Dasiuss/Szusownik/supabase/functions/README.md

# supabase/functions/

Tu trafiają **Edge Functions** (każda w osobnym podfolderze z `index.ts`).

Planowane: `strava-upload/` — proxy do Strava (OAuth + upload FIT), na końcu.

Wdrażane automatycznie przez integrację Supabase ↔ GitHub przy push na `main`.
