Dasiuss/Szusownik/docs/assets/ikonki.png

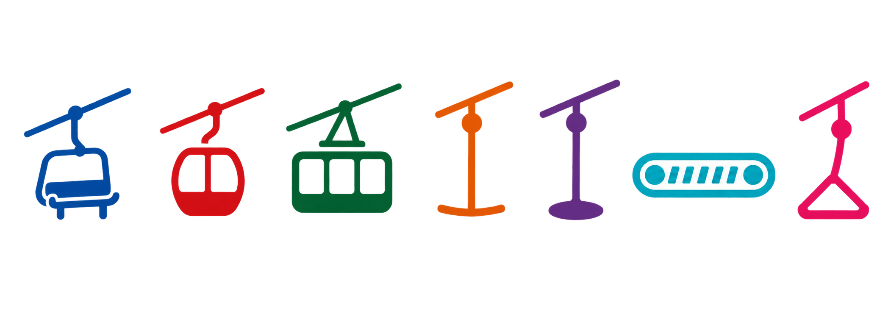
docs/assets/ikonki.png
