Dasiuss/Szusownik/test data/20260926_181420.csv

timestamp | lat | lon | speed | altitude_gps | heading | altitude_baro | gnss_fix_valid | gnss_fix_age_ms | gnss_satellites | gnss_satellites_age_ms | gnss_hdop | gnss_hdop_age_ms
2026-09-26T18:14:20.000Z | 51.050496 | 17.031226 | 1.6 | 130.8 | 189 | 40.3 | 1 | 25 | 12 | 2011 | 0.80 | 2011
2026-09-26T18:14:22.000Z | 51.050465 | 17.031216 | 9.6 | 131.0 | 191 | 40.5 | 1 | 13 | 12 | 1984 | 0.73 | 1984
2026-09-26T18:14:24.000Z | 51.050398 | 17.031197 | 16.0 | 131.1 | 190 | 39.8 | 1 | 13 | 12 | 1996 | 0.80 | 1996
2026-09-26T18:14:26.000Z | 51.050314 | 17.031166 | 17.9 | 130.9 | 193 | 39.7 | 1 | 13 | 12 | 1998 | 0.80 | 1998
2026-09-26T18:14:28.000Z | 51.050192 | 17.031119 | 26.8 | 130.5 | 191 | 40.2 | 1 | 71 | 12 | 2054 | 0.73 | 2054
2026-09-26T18:14:30.000Z | 51.050040 | 17.031069 | 34.9 | 130.5 | 192 | 40.9 | 1 | 12 | 12 | 3997 | 0.73 | 3997
2026-09-26T18:14:31.000Z | 51.049949 | 17.031033 | 38.6 | 130.4 | 192 | 40.5 | 1 | 13 | 12 | 998 | 0.73 | 998
2026-09-26T18:14:32.000Z | 51.049851 | 17.030997 | 40.5 | 130.2 | 192 | 40.0 | 1 | 13 | 12 | 996 | 0.73 | 996
2026-09-26T18:14:33.000Z | 51.049744 | 17.030958 | 43.7 | 130.4 | 192 | 40.8 | 1 | 12 | 12 | 997 | 0.72 | 997
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
