Dasiuss/Szusownik/firmware/Szusownik/Szusownik.ino

// Szusownik v1 — ESP32-S3-Zero, budowanie: arduino-cli (nie PlatformIO).
// FQBN: esp32:esp32:esp32s3:FlashSize=4M,PSRAM=enabled,USBMode=hwcdc,CDCOnBoot=cdc
// SSOT pinout: firmware/README.md
#include <Arduino.h>
#include <esp_system.h>
#include <TinyGPSPlus.h>
#include "src/config/pins.h"
#include "src/config/config.h"
#include "src/config/log.h"
#include "src/gnss/gnss.h"
#include "src/storage/storage.h"
#include "src/audio/audio.h"
#include "src/hud/hud.h"
#include "src/baro/baro.h"
#include "src/ble/ble.h"
#include "src/health/health.h"
#include "src/link/hud_link.h"
#include "src/core/run_tracker.h"
#include "src/core/hud_format.h"
#include "src/core/route.h"

static Gnss gnss;
static Storage storage;
static Beeper beeper;
static Hud hud;
static Baro baro;
static BleFiles ble;
static Health health;
static HudLink hudLink;
static core::RunTracker runTracker;

// Trasa nawigacyjna (RAM). Tożsamość = CRC32 bloba (routeVersion).
static RouteData activeRoute;
static uint32_t lastRouteVersion = 0;
static bool arrivalCleared = false;
// Ostatni znany odcinek trasy — zamrazany przy chwilowym braku fixa, żeby dolna
// linia OLED nie migotała i pokazywała ostatni znany stan.
static uint8_t routeSegmentNow = HUD_SEGMENT_NONE;
// Decyzja o bieżącym odcinku to pełny przebieg po punktach trasy (O(pointCount),
// double sqrt) — liczymy ją rzadko (SZ_ROUTE_UPDATE_MS), nie co iterację.
static unsigned long nextRouteMs = 0;
// Osobny, krótszy licznik na sprawdzenie dotarcia (odległość do końca, O(1)).
static unsigned long nextArrivalMs = 0;

// Statystyki dnia (reset przy restarcie = "max dnia od włączenia").
static float maxDayKmh = 0.0f;
static float totalKm = 0.0f;
static double prevLat = 0.0, prevLon = 0.0;
static bool havePrev = false;

static unsigned long nextHud = 0;
static unsigned long nextSync = 0;

// Miernik tempa zapisu i epok GNSS w oknie statusu.
static uint32_t totalSamples = 0;   // wiersze zapisane od startu
static uint32_t windowSamples = 0;  // wiersze w bieżącym oknie
static uint32_t windowEpochs = 0;   // epoki GNSS w bieżącym oknie
static unsigned long lastEpochMs = 0;
static unsigned long maxEpochGapMs = 0;
static unsigned long windowStart = 0;

// Zdarzenia (przejścia) — logowane raz, nie co próbkę.
static bool prevFix = false;
static bool prevTimeValid = false;

// Zdrowie pętli.
static unsigned long lastLoopMs = 0;
static unsigned long maxLoopMs = 0;
static uint32_t loopStallCount = 0;
static bool loopStallWarned = false;
static uint32_t loopIterations = 0;

static const char* resetReasonName(esp_reset_reason_t r) {
  switch (r) {
    case ESP_RST_POWERON: return "poweron";
    case ESP_RST_EXT: return "external";
    case ESP_RST_SW: return "software";
    case ESP_RST_PANIC: return "panic";
    case ESP_RST_INT_WDT: return "int_wdt";
    case ESP_RST_TASK_WDT: return "task_wdt";
    case ESP_RST_WDT: return "wdt";
    case ESP_RST_BROWNOUT: return "brownout";
    case ESP_RST_SDIO: return "sdio";
    default: return "other";
  }
}

void setup() {
  // Zegar CPU ustawiamy PRZED Serial i peryferiami: UART/I2C/LEDC mają wtedy
  // docelowy zegar od startu (patrz config.h).
  setCpuFrequencyMhz(SZ_CPU_FREQ_MHZ);
  Serial.begin(115200);
  unsigned long t0 = millis();
  while (!Serial && millis() - t0 < 1500) {
  }
  SZ_LOGIF("Szusownik %s proto=%s", SZ_FW_VERSION, SZ_WIRE_PROTO);
  SZ_LOGIF("BOOT reset=%s cpu=%luMHz heap=%lu psram=%lu", resetReasonName(esp_reset_reason()),
           (unsigned long)getCpuFrequencyMhz(), (unsigned long)ESP.getFreeHeap(),
           (unsigned long)ESP.getFreePsram());

  gnss.begin(9600);  // NEO-M8N default; reszta (rate/baud/zapis) w gnss.maintain()
  if (!storage.begin()) {
    SZ_LOGE("SD blad init");
  } else {
    SZ_LOGI("SD ok");  // plik powstanie dopiero przy poprawnej dacie/czasie GNSS
  }
  if (!hud.begin()) {
    SZ_LOGE("OLED blad init");
  }
  if (!baro.begin()) {
    SZ_LOGE("BARO blad init");
  } else if (baro.read()) {
    SZ_LOGIF("BARO %s @0x%02X P=%.1f Pa T=%.1f C alt=%.1f m", baro.typeName(), baro.address(),
             baro.pressurePa(), baro.tempC(), baro.altitudeM());
  } else {
    SZ_LOGIF("BARO %s @0x%02X (odczyt blad)", baro.typeName(), baro.address());
  }
  beeper.begin();
  beeper.playBoot();  // sygnał 120 (1 długi + 2 krótkie) przy głośności 60
  ble.setBeeper(&beeper);
  ble.begin(&storage);
  health.begin(&storage, &beeper, &hud, &baro);
  hudLink.begin();  // ESP-NOW do HudRekaw (kanał 1)
  lastRouteVersion = ble.routeVersion();
  routeDecode(ble.routeRaw(), ble.routeRawLen(), &activeRoute);
  hudLink.setRoute(ble.routeRaw(), ble.routeRawLen(), lastRouteVersion);

  windowStart = millis();
  nextSync = windowStart + SZ_SD_COMMIT_MS;
  SZ_LOGI("BOOT ok");
}

void loop() {
  unsigned long now = millis();

  // --- zdrowie pętli (wykrywa blokady I2C/SD/BLE/Serial) ---
  if (lastLoopMs) {
    unsigned long dt = now - lastLoopMs;
    if (dt > maxLoopMs) maxLoopMs = dt;
    if (dt >= SZ_LOOP_STALL_WARN_MS) {
      loopStallCount++;
      if (!loopStallWarned) {
        SZ_LOGWF("SYS loop stall %lums", dt);
        loopStallWarned = true;
      }
    }
  }
  lastLoopMs = now;
  loopIterations++;

  gnss.poll();
  gnss.maintain(now);  // autokonfiguracja UBX (co 5 s aż do skutku) + logi
  bool fix = gnss.hasFix();
  float kmh = fix ? gnss.speedKmh() : 0.0f;

  // Zdarzenia GNSS (raz na przejście, nie per próbka).
  if (fix != prevFix) {
    if (fix) {
      SZ_LOGIF("GNSS fix acquired sats=%lu hdop=%.2f", (unsigned long)gnss.sats(), gnss.hdop());
    } else {
      SZ_LOGIF("GNSS fix lost (sats=%lu age=%lums)", (unsigned long)gnss.sats(),
               gnss.locationAgeMs());
    }
    prevFix = fix;
  }
  if (!prevTimeValid && gnss.timeValid()) {
    prevTimeValid = true;
    SZ_LOGI("GNSS UTC valid (mozna tworzyc plik)");
  }

  // Rolka na postoju: domyka plik, gdy stoimy (chroni dane przed odcięciem
  // zasilania). Wołane co iterację (na millis), nie tylko na nowej próbce.
  storage.updateFileRotation(kmh, fix);
  // .meta po potwierdzonym ruchu: bez niego plik jest uznawany za postojowy
  // i nie trafia do listy pobierania (PWA go nie widzi).
  storage.ensureMeta();

  // Zapis na nadejście nowej próbki GNSS (commit RMC), nie na zegarze pętli.
  // Gwarantuje 1 wiersz = 1 pomiar i brak duplikatów przy dudnieniu zegarów.
  if (gnss.consumeNewSample()) {
    windowEpochs++;
    if (lastEpochMs) {
      unsigned long gap = now - lastEpochMs;
      if (gap > maxEpochGapMs) maxEpochGapMs = gap;
    }
    lastEpochMs = now;

#if SZ_LOG_LEVEL >= 3
    // Jedyna per-próbka linia (DEBUG). Wycinana kompilacyjnie w produkcji —
    // dane per próbka są trwale w CSV, a status okresowy wystarcza do oceny.
    SZ_LOGDF("GNSS smpl ok=%d spd=%.1f sats=%lu hdop=%.2f age=%lums altBaro=%.1f "
             "lat=%.6f lon=%.6f alt=%.1f hdg=%.0f",
             fix ? 1 : 0, kmh, (unsigned long)gnss.sats(), gnss.hdop(), gnss.locationAgeMs(),
             baro.valid() ? baro.altitudeM() : 0.0f, gnss.lat(), gnss.lon(), gnss.altM(),
             gnss.headingDeg());
#endif

    if (fix) {
      // Statystyki dnia (max i dystans) liczymy raz na nową próbkę — nie co
      // iterację pętli: haversine to 8 transcendentalnych `double`, a wartość
      // zmienia się dopiero na nowej epoce GNSS. Max zjazdu liczy
      // core::RunTracker (port ZigZag z PWA) niżej.
      if (kmh > maxDayKmh) maxDayKmh = kmh;
      if (kmh >= SZ_SPD_STATIC_BELOW_KMH) {
        double la = gnss.lat(), lo = gnss.lon();
        if (havePrev) {
          double d = TinyGPSPlus::distanceBetween(prevLat, prevLon, la, lo);
          if (d >= 0.0 && d < 200.0) totalKm += (float)(d / 1000.0);
        }
        prevLat = la;
        prevLon = lo;
        havePrev = true;
      }

      // Baro czytamy raz na epokę (i tak potrzebny do CSV i do fuzji HUD).
      if (baro.present()) baro.read();
      const bool baroOk = baro.present() && baro.valid();
      const float baroAlt = baroOk ? baro.altitudeM() : 0.0f;

      // HUD: tracker zjazdu (fuzja baro+GPS + ZigZag) na każdej epoce z fixem.
      runTracker.update(kmh, gnss.altM(), baroAlt, true, now);

      // Plik powstaje dopiero, gdy GNSS poda poprawną datę/czas (nazwa = UTC).
      // Bez tego nie nazwiemy pliku, więc próbkę pomijamy i nie dotykamy SD.
      if (storage.isReady() && !storage.isOpen()) {
        String stamp = gnss.utcStamp();
        if (stamp.length()) storage.openLog(stamp);
      }
      if (storage.isReady() && storage.isOpen()) {
        const GnssSampleQuality quality = gnss.sampleQuality();
        storage.writeSample(gnss.csvStamp(), gnss.lat(), gnss.lon(), kmh, gnss.altM(),
                            gnss.headingDeg(), baroAlt, quality);
        totalSamples++;
        windowSamples++;
      }
    }
  }

  if (now >= nextSync) {
    nextSync = now + SZ_SD_COMMIT_MS;
    // fsync (`File::flush` -> f_sync) dzieli SPI z odczytem transferu i na tej
    // karcie potrafi być długi. W trakcie transferu pomijamy go (dane w buforze
    // stdio domkną się po transferze albo na rolce), żeby nie zjadał zegara ACK.
    if (!ble.busy()) storage.sync();
  }
  if (now >= nextHud) {
    nextHud = now + 500;
    int utcHour = -1, utcMinute = 0, utcSecond = 0;
    char routeLine[SZ_HUD_ROUTE_CHARS + 1];
    gnss.utcTime(utcHour, utcMinute, utcSecond);
    HudData data;
    data.speedKmh = kmh;
    data.maxRunKmh = runTracker.displayMaxKmh();
    data.maxDayKmh = maxDayKmh;
    data.totalKm = totalKm;
    data.altitudeM = runTracker.altitudeM();
    data.utcHour = utcHour;
    data.utcMinute = utcMinute;
    data.hasFix = fix;
    // Dolna linia: kolejne odcinki od bieżącego (albo od początku, gdy odcinek
    // jeszcze nieznany). Bez trasy linia zostaje pusta (pełny ekran statystyk).
    data.routeLine = nullptr;
    if (activeRoute.valid && activeRoute.segmentCount > 0) {
      const uint8_t start =
          routeSegmentNow != HUD_SEGMENT_NONE ? routeSegmentNow : 0;
      routeFormatLine(activeRoute, start, routeLine, sizeof(routeLine));
      if (routeLine[0] != '\0') data.routeLine = routeLine;
    }
    hud.draw(data);
  }

  // Jedna linia statusu (DEBUG) zamiast dawnych "GPS:" + "LOG:".
  if (now - windowStart >= SZ_STATUS_MS) {
    unsigned long win = now - windowStart;
    float sampleHz = win ? windowSamples * 1000.0f / (float)win : 0.0f;
    float epochHz = win ? windowEpochs * 1000.0f / (float)win : 0.0f;
    float loopAvg = loopIterations ? (float)win / (float)loopIterations : 0.0f;
    float airC = (baro.present() && baro.valid()) ? baro.tempC() : 0.0f;
    SZ_LOGDF("SYS fix=%d sats=%lu hdop=%.2f age=%lums band=%d rate=%lums cfg=%d chars=%lu "
             "ubxfail=%lu | sd=%s file=%s wr=%lu err=%lu syncMax=%lums | "
             "smp=%.2fHz ep=%.2fHz gapMax=%lums | loop=%.1f/%lums stall=%lu | "
             "heap=%lu min=%lu psram=%lu | die=%.1f air=%.1f | ble=%s mtu=%u nf=%lu",
             gnss.hasFix() ? 1 : 0, (unsigned long)gnss.sats(), gnss.hdop(), gnss.locationAgeMs(),
             gnss.band(), gnss.logIntervalMs(), gnss.isConfigured() ? 1 : 0,
             (unsigned long)gnss.charsProcessed(), (unsigned long)gnss.ubxFails(),
             storage.isOpen() ? "open" : "idle", storage.currentName().c_str(),
             (unsigned long)totalSamples, (unsigned long)storage.writeErrors(),
             storage.syncMaxMs(), sampleHz, epochHz, maxEpochGapMs, loopAvg, maxLoopMs,
             (unsigned long)loopStallCount, (unsigned long)ESP.getFreeHeap(),
             (unsigned long)ESP.getMinFreeHeap(), (unsigned long)ESP.getFreePsram(),
             temperatureRead(), airC, ble.busy() ? "xfer" : "idle", (unsigned)ble.mtu(),
             (unsigned long)ble.notifyFails());

    windowStart = now;
    windowSamples = 0;
    windowEpochs = 0;
    maxEpochGapMs = 0;
    maxLoopMs = 0;
    loopStallCount = 0;
    loopStallWarned = false;
    loopIterations = 0;
    storage.resetSyncStats();
  }

  beeper.tick(kmh, now);
  health.tick(now);  // termika: alarm >95C, deep sleep >100C
  ble.poll();  // callback BLE tylko ustawia flagi (poll czyta CTRL); bez blokowania SD
  // Reklamowanie zależne od prędkości: na postoju szybkie (PWA łączy się od razu),
  // w ruchu wolne (mniej grzania). Tanie — przełącza tylko przy zmianie stanu.
  ble.updateAdvForSpeed(kmh);

  // Trasa nawigacyjna: wykryj zmianę wersji (PWA albo lokalny CLEAR po dotarciu),
  // przelicz bieżący odcinek i obsłuż dotarcie do celu.
  const uint32_t routeVersion = ble.routeVersion();
  if (routeVersion != lastRouteVersion) {
    lastRouteVersion = routeVersion;
    routeDecode(ble.routeRaw(), ble.routeRawLen(), &activeRoute);
    hudLink.setRoute(ble.routeRaw(), ble.routeRawLen(), routeVersion);
    arrivalCleared = false;
    routeSegmentNow = HUD_SEGMENT_NONE;  // nowa trasa: brak znanego odcinka
    nextRouteMs = 0;                     // nowa trasa: przelicz od razu
    nextArrivalMs = 0;
  }

  // Dotarcie: odległość do końca trasy jest O(1) — sprawdzamy ją co najwyżej raz
  // na SZ_ROUTE_ARRIVAL_MS. Rzadsze próbkowanie mogłoby przy dużej prędkości
  // przeskoczyć cały promień ROUTE_ARRIVAL_M (~60 m okna) i zgubić dotarcie.
  if (activeRoute.valid && fix && !arrivalCleared && now >= nextArrivalMs) {
    nextArrivalMs = now + SZ_ROUTE_ARRIVAL_MS;
    if (routeDistanceToEndM(activeRoute, gnss.lat(), gnss.lon()) <= ROUTE_ARRIVAL_M) {
      arrivalCleared = true;
      ble.clearRoute();  // trasa znika też z HudRekaw (przez ESP-NOW)
    }
  }

  // Bieżący odcinek: pełny przebieg po punktach trasy liczymy co najwyżej raz na
  // SZ_ROUTE_UPDATE_MS (odcinek zmienia się wolno, a liczenie w każdej iteracji
  // dogrzewało SoC). Między przeliczeniami pakiet niesie ostatni znany odcinek.
  uint8_t segmentIndex = HUD_SEGMENT_NONE;
  if (activeRoute.valid && fix) {
    if (now >= nextRouteMs) {
      nextRouteMs = now + SZ_ROUTE_UPDATE_MS;
      routeSegmentNow = routeSegmentIndex(activeRoute, gnss.lat(), gnss.lon());
    }
    segmentIndex = routeSegmentNow;
  }
  if (!activeRoute.valid) routeSegmentNow = HUD_SEGMENT_NONE;

  // ESP-NOW do HudRekaw. Pauza w trakcie transferu BLE chroni sprawdzone pasmo.
  HudInput hudIn;
  hudIn.fix = fix;
  hudIn.speedKmh = kmh;
  hudIn.maxDayKmh = static_cast<uint16_t>(maxDayKmh + 0.5f);
  hudIn.heading = static_cast<int16_t>(lroundf(gnss.headingDeg()));
  hudIn.totalKm = totalKm;
  hudIn.latE7 = static_cast<int32_t>(lround(gnss.lat() * 1e7));
  hudIn.lonE7 = static_cast<int32_t>(lround(gnss.lon() * 1e7));
  hudIn.segmentIndex = segmentIndex;

  // Parowanie HUD (zlecone z PWA przez BLE): zlecenie → HudLink, wynik → PWA.
  // Sparowany MAC trafia też do INFO (ble.setHudPeer) dla widoku w PWA. INFO
  // aktualizujemy PRZED STATUS-em wyniku — PWA czyta INFO zaraz po STATUS-ie,
  // więc przy odwrotnej kolejności widziałaby stary peerMac. setHudPeer odświeża
  // INFO tylko przy rzeczywistej zmianie (jedno skanowanie katalogu SD).
  if (ble.takePairRequest()) hudLink.requestPairing();
  ble.setHudPeer(hudLink.peerMac());
  HudPairResult pairResult;
  if (hudLink.takePairResult(pairResult)) {
    char msg[48];
    if (pairResult == HudPairResult::Ok) {
      const uint8_t* m = hudLink.peerMac();
      snprintf(msg, sizeof(msg), SZ_ST_PAIRED " %02X:%02X:%02X:%02X:%02X:%02X", m[0], m[1], m[2],
               m[3], m[4], m[5]);
      ble.reportHudPair(msg);
    } else if (pairResult == HudPairResult::None) {
      ble.reportHudPair(SZ_ERR_PAIR_NONE);
    } else if (pairResult == HudPairResult::TooMany) {
      ble.reportHudPair(SZ_ERR_PAIR_MULTI);
    } else {
      ble.reportHudPair(SZ_ST_ERR "pair");
    }
  }

  // Świeży czas dla linku HUD: od początku loop() do tego miejsca mogą wystąpić
  // blokujące operacje (skan katalogu SD w refreshInfo po wyczyszczeniu MAC-a
  // przy parowaniu, zapis SD), a okna nadawania i okno zbierania odpowiedzi na
  // 'P' (prośba o parowanie) liczą się od rzeczywistego „teraz".
  hudLink.tick(millis(), hudIn, ble.busy());

  // Oddaj CPU na chwilę, ale NIE w trakcie transferu BLE: profil BLE jest
  // zamrożony (spacing NOTIFY 4 ms), więc pompa musi kręcić się bez sztucznego
  // opóźnienia. Poza transferem delay wpuszcza idle/DFS i ogranicza grzanie
  // SoC; 3 ms nie rusza żadnego interwału (najszybszy to GNSS 10 Hz = 100 ms).
  if (!ble.busy()) delay(SZ_LOOP_IDLE_MS);
}
