Dasiuss/Szusownik/firmware/Szusownik/src/config/config.h

#pragma once
#include <Arduino.h>
#include "protocol.h"

// Szusownik v1 — stałe konfiguracyjne. SSOT decyzji: docs/koncepcja.md,
// docs/wymagania-ESP.md, docs/ble-transfer.md, docs/jakosc-danych.md.

#define SZ_FW_VERSION "1.9.0-hud-espnow"
// SZ_WIRE_PROTO, SZ_CSV_HEADER i SZ_CSV_META_SUFFIX są w protocol.h.

// Adaptacyjne próbkowanie (docs/koncepcja.md): <20:0.5Hz, 20-50:1Hz,
// 50-70:3Hz, 70-80:6Hz, >=80:10Hz. Histereza +/-3 km/h.
static const float SZ_HYST_KMH = 3.0f;

// Buzzer: mapowanie prędkość -> wzór jest w audio.cpp; zakresy i wartości
// domyślne (częstotliwości, czasy tonów/przerw, próg pikania, głośność) są
// w protocol.h — PWA i firmware czytają te same liczby.


// Rotacja pliku na postoju (wymagania-ESP.md §7). Gdy prędkość spadnie poniżej
// SZ_ROLL_STOP_BELOW_KMH i utrzyma się przez SZ_ROLL_HOLD_MS, bieżący plik jest
// domykany — w chwili odcięcia zasilania otwarty jest już tylko plik z próbkami
// z postoju (bezwartościowy). Ponowne uzbrojenie rolki dopiero po prędkości
// > SZ_ROLL_REARM_ABOVE_KMH przez SZ_ROLL_HOLD_MS, więc jeden postój = jedna
// rolka (bez mnożenia plików); ruch < SZ_ROLL_REARM_ABOVE_KMH nie jest chroniony.
#define SZ_ROLL_STOP_BELOW_KMH 0.3f
#define SZ_ROLL_REARM_ABOVE_KMH 5.0f
#define SZ_ROLL_HOLD_MS 3000UL

// Monitoring zdrowia urzadzenia (modul Health). MVP: termika SoC.
// ESP32-S3 NIE ma sprzetowego zabezpieczenia termicznego, wiec ochrona jest
// programowa: sprawdzenie co SZ_HEALTH_CHECK_MS; po SZ_HEALTH_WARN_CONFIRM
// kolejnych odczytach >= WARN kazdy kolejny odczyt >= WARN daje alarm buzzerem
// (SZ_HEALTH_ALARM_MS). Przy >= CRIT: zamkniecie SD, ekran, alarm i deep sleep.
// Uwaga: temperatureRead() jest slabo skalibrowany bezwzglednie — progi
// ustawione z zapasem (CRIT 100 < junction max 125). Histereza chroni przed
// zatrzasnieciem alarmu po ostygnięciu.
#define SZ_HEALTH_CHECK_MS 30000UL
#define SZ_HEALTH_TEMP_WARN_C 95.0f
#define SZ_HEALTH_TEMP_CRIT_C 100.0f
#define SZ_HEALTH_WARN_CONFIRM 3
#define SZ_HEALTH_ALARM_MS 3000
#define SZ_HEALTH_HYST_C 2.0f

// HUD: próg ruchu dla liczenia dystansu (km). SPD na ekranie pokazuje zawsze
// bieżącą prędkość; hero "max zjazdu" liczy core::RunTracker (port ZigZag z PWA).
#define SZ_SPD_STATIC_BELOW_KMH 5.0f

// HUD: strefa czasowa (minuty) dla wyświetlanego czasu lokalnego (UTC+offset).
#define SZ_HUD_TZ_OFFSET_MIN 60

// HUD: pojemność dolnej linii trasy. W trybie trasy napis jest rozmiaru 2
// (12 px/znak) od x=1 — mieści się 10 znaków przy szerokości 128 px. Dłuższy
// napis jest urywany w środku nazwy, bez wiszącego "->".
#define SZ_HUD_ROUTE_CHARS 10

// Trasa nawigacyjna: maksymalna częstość przeliczania bieżącego odcinka.
// Pełny przebieg po punktach trasy (O(pointCount), double sqrt) jest kosztowny,
// a odcinek zmienia się wolno — liczymy go najwyżej raz na ten interwał.
// Odległość do końca trasy (wykrycie dotarcia) jest O(1) i sprawdzana osobno,
// nie rzadziej niż SZ_ROUTE_ARRIVAL_MS — rzadsze próbkowanie przy dużej
// prędkości mogłoby przeskoczyć promień ROUTE_ARRIVAL_M i zgubić dotarcie.
#define SZ_ROUTE_UPDATE_MS 3000UL
#define SZ_ROUTE_ARRIVAL_MS 1000UL

// Przekazywanie trasy do HudRekaw po ESP-NOW: minimalny odstęp między oknami
// wysyłki trasy. Okno = burst chunków `R` (każdy następny po ACK poprzedniego)
// zakończony oczekiwaniem na jawne potwierdzenie `K` z CRC, do
// HUD_ROUTE_MAX_CYCLES prób (patrz protocol/hud-espnow-v1.json). Po nieudanym
// oknie czekamy — Hud zgłosi inną wersję trasy, ale bez tego progu burst
// restartowałby się natychmiast i radio nadawało non-stop (dogrzewanie).
// Szczegóły: docs/hud-rekaw.md §3.
#define SZ_HUD_ROUTE_RESEND_MS 9000UL

// Detekcja zjazdu (port ZigZag z web/src/lib/runs.ts): histereza zwrotu
// wysokości, stała czasowa fuzji baro+GPS i twarda granica przerwy.
#define SZ_RUN_REVERSAL_M 5.0f
#define SZ_RUN_ALT_TAU_S 10.0f
#define SZ_RUN_MAX_GAP_MS 3600000UL

// Poziom logowania na Serial: 0=ERR 1=WARN 2=INFO (domyslny) 3=DEBUG.
// INFO = zdarzenia (fix, SD, BLE, health, boot) + cykl transferu BLE;
// DEBUG = status okresowy, per-probka GNSS, diagnostyka UBX/INFO/BLE.
// Wszystko ponizej progu jest wycinane kompilacyjnie (src/config/log.h).
#define SZ_LOG_LEVEL 3

// Linia statusu SYS (DEBUG) i progi ostrzezen.
#define SZ_STATUS_MS 5000UL          // okres linii SYS: GNSS/SD/loop/heap/termika/BLE
#define SZ_SD_SYNC_WARN_MS 100UL     // wolny flush (fsync) -> WARN
#define SZ_LOOP_STALL_WARN_MS 200UL  // dluzsza iteracja petli -> WARN (pierwsza w oknie)

// Pętla główna: minimalny czas oddany CPU między iteracjami. Bez tego loop()
// jest busy-spinem — CPU tkwi na 100%, nie wchodzi w idle/DFS i grzeje SoC
// (a radia BLE/ESP-NOW są włączone przez cały czas). 3 ms nie rusza żadnego
// interwału (najszybszy to GNSS 10 Hz = 100 ms; BLE ma własny pacing 4 ms).
#define SZ_LOOP_IDLE_MS 3

// Stały zegar CPU. ESP32-S3 obsługuje 240/160/80/40/20 MHz — 200 MHz NIE
// istnieje (setCpuFrequencyMhz(200) kończy się błędem i zostawia 240). 160 MHz
// zmniejsza moc dynamiczną, a zapas na deflate w transferze BLE zostaje.
// Ustawiane raz w setup(), PRZED inicjalizacją peryferiów, żeby UART/I2C/LEDC
// wystartowały z docelowym zegarem.
#define SZ_CPU_FREQ_MHZ 160

// Punkt montowania FAT (SD.begin). Musi być jawny, bo tanie listowanie
// (opendir/readdir) używa pełnej ścieżki VFS — `opendir("/")` patrzy na korzeń
// VFS bez systemu plików i zwraca NULL. Domyślna wartość SD to "/sd".
#define SZ_SD_MOUNT "/sd"

// FIFO: przy mniej niż tyle wolnego miejsca kasuj najstarsze pliki CSV.
#define SZ_SD_MIN_FREE_BYTES (4UL * 1024UL * 1024UL)

// Co tyle ms robimy flush bieżącego pliku (File::flush -> fsync -> FATFS f_sync,
// czyli domknięcie wpisu katalogowego i FAT na karcie). Ogranicza okno utraty
// danych przy odcięciu zasilania w trakcie jazdy; koniec jazdy chroni rolka.
#define SZ_SD_COMMIT_MS 10000UL

// BLE — profil ZAMROŻONY (docs/ble-transfer.md). Wszystkie stałe protokołu
// (ramki, okno, ACK, UUID, nazwa) są w protocol.h — zmiana tylko po benchmarku
// na rzeczywistym ESP32 + Androidzie.

// BLE: interwał reklamowania (NimBLE, jednostka 0.625 ms). Reklamujemy SZYBKO,
// gdy stoimy — wtedy najczęściej łączymy się z PWA — a WOLNO w ruchu. Adv trwa
// tylko bez połączenia, więc wolny tryb ogranicza grzanie w trakcie jazdy bez
// wpływu na zamrożony profil transferu (docs/ble-transfer.md).
// Szybki: 400 = 250 ms.
#define SZ_BLE_ADV_FAST_INTERVAL 400
// Wolny: 1600 = 1 s.
#define SZ_BLE_ADV_SLOW_INTERVAL 1600
// Próg przełączenia na szybkie reklamowanie; na wolne wracamy dopiero wyżej o
// histerezę SZ_HYST_KMH (5 -> 8 km/h), żeby szum GNSS nie restartował adv
// w kółko. Brak fixu liczy się jak postój (szybkie).
#define SZ_BLE_ADV_FAST_BELOW_KMH 5.0f

// BLE: maksymalny ciągły zastój WYSYŁKI (notify() zwraca false — łącze nie
// przyjmuje ramek, np. zapchana pula mbufów po stronie kontrolera). Do tego czasu
// czekamy i ponawiamy zamiast przerywać (zastój sam mija, a ponowienie PWA jest
// kosztowne); po nim dopiero err:ack-timeout. To NIE zmiana zamrożonego profilu
// (ramki/pacing/okno bez zmian) — tylko bezpiecznik na czas oczekiwania.
#define SZ_BLE_SEND_STALL_MAX_MS 10000UL
