Dasiuss/Szusownik/firmware/HudRekaw/src/display/display.cpp

#include "display.h"

#include <Fonts/FreeSans9pt7b.h>
#include <Fonts/FreeSansBold12pt7b.h>
#include <Fonts/FreeSansBold24pt7b.h>
#include <math.h>

#include "../config/config.h"
#include "../core/hud_format.h"
#include "../core/map_math.h"
#include "../map/map_data.h"

namespace {

// Bufor kandydatów labeli MUSI być statyczny. ESP8266 ma 4 KB stosu zadania
// loop(); tablica ~220 x 20 B (~4,4 KB) na stosie przepełnia go i resetuje
// urządzenie przy pierwszej ramce `L`. Tak samo trzymał ją odbiornik DisplayTest.
MapLabelBox gLabelCandidates[MAP_MAX_CANDIDATES];

void copyLabelText(char* buffer, uint8_t bufferSize, uint16_t offset, uint8_t length) {
  uint8_t count = length;
  if (count > bufferSize - 1) count = bufferSize - 1;
  for (uint8_t index = 0; index < count; index++) {
    buffer[index] = static_cast<char>(pgm_read_byte(&mapNames[offset + index]));
  }
  buffer[count] = '\0';
}

}  // namespace

bool Display::begin() {
  pinMode(TFT_BL_PIN, OUTPUT);
  digitalWrite(TFT_BL_PIN, LOW);  // podświetlenie aktywne w stanie niskim
  tft_.setSPISpeed(TFT_SPI_HZ);
  tft_.init(TFT_WIDTH, TFT_HEIGHT, SPI_MODE3);
  tft_.setRotation(0);
  tft_.invertDisplay(true);
  tft_.fillScreen(COLOR_BG);
  return true;
}

int16_t Display::findNearestDownhillBearing(float riderEast, float riderNorth, bool* found) {
  int32_t best = 0x7FFFFFFF;
  int16_t bearing = 0;
  *found = false;
  for (uint16_t i = 0; i < MAP_WAY_COUNT; i++) {
    MapWay way;
    memcpy_P(&way, &mapWays[i], sizeof(MapWay));
    if (way.kind != 0 || way.pointCount == 0) continue;
    for (uint16_t j = 0; j < way.pointCount; j++) {
      MapPoint point;
      memcpy_P(&point, &mapPoints[way.firstPoint + j], sizeof(MapPoint));
      const int32_t dx = point.east - static_cast<int32_t>(riderEast);
      const int32_t dy = point.north - static_cast<int32_t>(riderNorth);
      const int32_t distance = dx * dx + dy * dy;
      if (distance < best) {
        best = distance;
        bearing = way.bearing;
        *found = true;
      }
    }
  }
  return bearing;
}

// Bresenham z Adafruit_GFX::writeLine, ale przez writePixel() (bez
// startWrite/endWrite). Wołany TYLKO wewnątrz transakcji otwartej w drawMap.
void Display::drawMapLine(int16_t x0, int16_t y0, int16_t x1, int16_t y1, uint16_t color) {
  const bool steep = abs(y1 - y0) > abs(x1 - x0);
  if (steep) {
    int16_t swap = x0;
    x0 = y0;
    y0 = swap;
    swap = x1;
    x1 = y1;
    y1 = swap;
  }
  if (x0 > x1) {
    int16_t swap = x0;
    x0 = x1;
    x1 = swap;
    swap = y0;
    y0 = y1;
    y1 = swap;
  }
  const int16_t dx = x1 - x0;
  const int16_t dy = abs(y1 - y0);
  int16_t err = dx / 2;
  const int16_t ystep = (y0 < y1) ? 1 : -1;
  for (; x0 <= x1; x0++) {
    if (steep) {
      tft_.writePixel(y0, x0, color);
    } else {
      tft_.writePixel(x0, y0, color);
    }
    err -= dy;
    if (err < 0) {
      y0 += ystep;
      err += dx;
    }
  }
}

void Display::drawMapPolyline(uint16_t firstPoint, uint16_t pointCount, uint16_t color,
                              float riderEast, float riderNorth, float cosBearing, float sinBearing,
                              float fisheyeK, uint16_t fisheyeRadius) {
  if (pointCount < 2) return;
  MapPoint previous;
  memcpy_P(&previous, &mapPoints[firstPoint], sizeof(MapPoint));
  int16_t previousX;
  int16_t previousY;
  mapProjectPoint(previous.east, previous.north, riderEast, riderNorth, cosBearing, sinBearing,
                  fisheyeRadius, fisheyeK, &previousX, &previousY);
  for (uint16_t index = 1; index < pointCount; index++) {
    MapPoint current;
    memcpy_P(&current, &mapPoints[firstPoint + index], sizeof(MapPoint));
    int16_t currentX;
    int16_t currentY;
    mapProjectPoint(current.east, current.north, riderEast, riderNorth, cosBearing, sinBearing,
                    fisheyeRadius, fisheyeK, &currentX, &currentY);
    const bool bothLeft = previousX < -20 && currentX < -20;
    const bool bothRight = previousX > 259 && currentX > 259;
    const bool bothTop = previousY < -20 && currentY < -20;
    const bool bothBottom = previousY > 259 && currentY > 259;
    if (!(bothLeft || bothRight || bothTop || bothBottom)) {
      drawMapLine(previousX, previousY, currentX, currentY, color);
    }
    previousX = currentX;
    previousY = currentY;
  }
}

void Display::drawRoute(const HudRoute& route, float riderEast, float riderNorth, float cosBearing,
                        float sinBearing, float fisheyeK, uint16_t fisheyeRadius) {
  if (!route.valid || route.pointCount < 2) return;
  const float routeOriginLat = static_cast<float>(route.originLatE7) / 1e7f;
  const float routeOriginLon = static_cast<float>(route.originLonE7) / 1e7f;
  const float mapOriginLat = static_cast<float>(MAP_ORIGIN_LAT_E7) / 1e7f;
  const float mapOriginLon = static_cast<float>(MAP_ORIGIN_LON_E7) / 1e7f;
  const float lonScale = 111320.0f * cosf(routeOriginLat * PI / 180.0f);
  const float offsetEast = (routeOriginLon - mapOriginLon) * lonScale;
  const float offsetNorth = (routeOriginLat - mapOriginLat) * MAP_METERS_PER_DEG_LAT;

  tft_.startWrite();
  int16_t previousX = 0;
  int16_t previousY = 0;
  for (uint16_t index = 0; index < route.pointCount; index++) {
    const float mapEast = offsetEast + static_cast<float>(route.east[index]);
    const float mapNorth = offsetNorth + static_cast<float>(route.north[index]);
    int16_t x = 0;
    int16_t y = 0;
    mapProjectPoint(static_cast<int16_t>(mapEast), static_cast<int16_t>(mapNorth), riderEast,
                    riderNorth, cosBearing, sinBearing, fisheyeRadius, fisheyeK, &x, &y);
    if (index > 0) {
      // Gruba linia: pędzel ROUTE_LINE_THICKNESS x ROUTE_LINE_THICKNESS px —
      // przebiegi Bresenhama przesunięte o każdą kombinację offsetów.
      for (int16_t oy = 0; oy < ROUTE_LINE_THICKNESS; oy++) {
        for (int16_t ox = 0; ox < ROUTE_LINE_THICKNESS; ox++) {
          drawMapLine(previousX + ox, previousY + oy, x + ox, y + oy, COLOR_ROUTE);
        }
      }
    }
    previousX = x;
    previousY = y;
    if ((index & 0x3F) == 0) yield();
  }
  tft_.endWrite();
}

void Display::drawRouteSteps(const HudRoute& route, uint8_t segmentIndex, int16_t firstY,
                             int16_t lineStep) {
  if (!route.valid || route.segmentCount == 0) return;
  const int16_t bandHeight = static_cast<int16_t>(HUD_SEGMENTS_SHOWN * lineStep + 2);
  tft_.fillRect(0, firstY - 2, TFT_WIDTH, bandHeight, COLOR_BG);
  tft_.setFont(NULL);
  tft_.setTextSize(1);
  for (uint8_t row = 0; row < HUD_SEGMENTS_SHOWN; row++) {
    const uint16_t index = static_cast<uint16_t>(segmentIndex) + row;
    if (index >= route.segmentCount) break;
    const uint16_t color = row == 0 ? COLOR_ROUTE : COLOR_GRAY;
    tft_.setTextColor(color);
    tft_.setCursor(6, firstY + static_cast<int16_t>(row * lineStep));
    tft_.print(route.steps[index].label);
  }
}

void Display::drawMapLabels(float riderEast, float riderNorth, float cosBearing, float sinBearing,
                            float fisheyeK, uint16_t fisheyeRadius) {
  MapLabelBox* const candidates = gLabelCandidates;
  uint16_t count = 0;

  const auto addCandidate = [&](uint16_t nameOffset, uint8_t nameLength, uint8_t textSize,
                                uint16_t color, uint16_t firstPoint, uint16_t pointCount) {
    if (nameLength == 0 || count >= MAP_MAX_CANDIDATES || pointCount == 0) return;
    MapPoint middle;
    memcpy_P(&middle, &mapPoints[firstPoint + pointCount / 2], sizeof(MapPoint));
    int16_t screenX;
    int16_t screenY;
    mapProjectPoint(middle.east, middle.north, riderEast, riderNorth, cosBearing, sinBearing,
                    fisheyeRadius, fisheyeK, &screenX, &screenY);
    if (screenX < 0 || screenX > 239 || screenY < 0 || screenY > 239) return;

    const int16_t width = static_cast<int16_t>(6 * textSize) * nameLength;
    const int16_t height = static_cast<int16_t>(8 * textSize);
    int16_t left = screenX - width / 2;
    int16_t top = screenY - height / 2;
    if (left < 0) left = 0;
    if (top < 0) top = 0;
    if (left + width > 239) left = 239 - width;
    if (top + height > 239) top = 239 - height;

    const float dx = middle.east - riderEast;
    const float dy = middle.north - riderNorth;
    MapLabelBox& label = candidates[count];
    label.x = left;
    label.y = top;
    label.width = width;
    label.height = height;
    label.nameOffset = nameOffset;
    label.nameLength = nameLength;
    label.textSize = textSize;
    label.color = color;
    label.distanceSq = static_cast<int32_t>(dx * dx + dy * dy);
    count++;
  };

  for (uint16_t i = 0; i < MAP_WAY_COUNT; i++) {
    MapWay way;
    memcpy_P(&way, &mapWays[i], sizeof(MapWay));
    addCandidate(way.nameOffset, way.nameLength, 1, mapWayColor(way.kind, way.difficulty),
                 way.firstPoint, way.pointCount);
  }
  for (uint16_t i = 0; i < MAP_LIFT_COUNT; i++) {
    MapLift lift;
    memcpy_P(&lift, &mapLifts[i], sizeof(MapLift));
    addCandidate(lift.nameOffset, lift.nameLength, 1, COLOR_WHITE, lift.firstPoint, lift.pointCount);
  }

  mapSortLabelsByDistance(candidates, count);

  MapLabelBox placed[MAP_MAX_LABELS];
  for (uint8_t index = 0; index < MAP_MAX_LABELS; index++) placed[index].width = 0;

  uint8_t placedCount = 0;
  for (uint16_t i = 0; i < count && placedCount < MAP_MAX_LABELS; i++) {
    const MapLabelBox& candidate = candidates[i];
    if (mapLabelOverlaps(candidate, placed, placedCount)) continue;
    placed[placedCount++] = candidate;

    char buffer[12];
    copyLabelText(buffer, sizeof(buffer), candidate.nameOffset, candidate.nameLength);
    tft_.setFont(NULL);
    tft_.setTextSize(candidate.textSize);
    tft_.setTextColor(candidate.color);
    tft_.fillRect(candidate.x - 1, candidate.y - 1, candidate.width + 2, candidate.height + 2,
                  COLOR_BG);
    tft_.setCursor(candidate.x, candidate.y);
    tft_.print(buffer);
  }
  tft_.setTextSize(1);
}

void Display::drawRiderDot() {
  tft_.fillCircle(MAP_RIDER_X, MAP_RIDER_Y, 5, COLOR_RIDER);
  tft_.drawCircle(MAP_RIDER_X, MAP_RIDER_Y, 6, COLOR_WHITE);
}

bool Display::drawMap(const HudLocation& location, const HudRoute& route, bool force) {
  if (metersPerDegLon_ == 0.0f) {
    metersPerDegLon_ =
        111320.0f * cosf((static_cast<float>(MAP_ORIGIN_LAT_E7) / 1e7f) * PI / 180.0f);
  }
  uint8_t zoom = location.zoom;
  if (zoom >= MAP_VIEW_COUNT) zoom = MAP_VIEW_COUNT - 1;
  const float fisheyeK = static_cast<float>(MAP_VIEW_METERS[zoom]);
  const uint16_t fisheyeRadius = location.fisheye;

  const float riderEast = (static_cast<float>(location.lonE7) / 1e7f -
                           static_cast<float>(MAP_ORIGIN_LON_E7) / 1e7f) *
                          metersPerDegLon_;
  const float riderNorth = (static_cast<float>(location.latE7) / 1e7f -
                            static_cast<float>(MAP_ORIGIN_LAT_E7) / 1e7f) *
                           MAP_METERS_PER_DEG_LAT;

  bool found = false;
  const int16_t nearest = findNearestDownhillBearing(riderEast, riderNorth, &found);
  const int16_t bearing = found ? nearest : mapBearing_;

  // Martwa strefa: pomiń przerysowanie, gdy pozycja i kurs nie ruszyły się
  // wystarczająco, a zoom/fisheye/trasa się nie zmieniły.
  if (!force && mapDrawn_ && zoom == mapDrawnZoom_ && fisheyeRadius == mapDrawnFisheye_ &&
      route.crc == mapDrawnRouteCrc_ &&
      !mapShouldRedraw(mapDrawnEast_, mapDrawnNorth_, mapDrawnBearing_, riderEast, riderNorth,
                       bearing, MAP_REDRAW_MOVE_M, MAP_REDRAW_BEARING_DEG)) {
    return false;
  }

  mapBearing_ = bearing;
  mapDrawn_ = true;
  mapDrawnEast_ = riderEast;
  mapDrawnNorth_ = riderNorth;
  mapDrawnBearing_ = bearing;
  mapDrawnZoom_ = zoom;
  mapDrawnFisheye_ = fisheyeRadius;
  mapDrawnRouteCrc_ = route.crc;

  const float cosBearing = cosf(static_cast<float>(bearing) * PI / 180.0f);
  const float sinBearing = sinf(static_cast<float>(bearing) * PI / 180.0f);

  tft_.fillScreen(COLOR_BG);

  // Jedna transakcja SPI na wszystkie polilinie (drawMapLine przez writePixel).
  // fillScreen/labele/kropka zostają poza nią — wołają własne startWrite/endWrite.
  tft_.startWrite();
  for (uint16_t i = 0; i < MAP_WAY_COUNT; i++) {
    MapWay way;
    memcpy_P(&way, &mapWays[i], sizeof(MapWay));
    drawMapPolyline(way.firstPoint, way.pointCount, mapWayColor(way.kind, way.difficulty), riderEast,
                    riderNorth, cosBearing, sinBearing, fisheyeK, fisheyeRadius);
    if ((i & 0x1F) == 0) yield();  // watchdog: bez yield() z writeLine
  }
  for (uint16_t i = 0; i < MAP_LIFT_COUNT; i++) {
    MapLift lift;
    memcpy_P(&lift, &mapLifts[i], sizeof(MapLift));
    drawMapPolyline(lift.firstPoint, lift.pointCount, COLOR_LIFT, riderEast, riderNorth, cosBearing,
                    sinBearing, fisheyeK, fisheyeRadius);
  }
  tft_.endWrite();

  drawMapLabels(riderEast, riderNorth, cosBearing, sinBearing, fisheyeK, fisheyeRadius);
  drawRoute(route, riderEast, riderNorth, cosBearing, sinBearing, fisheyeK, fisheyeRadius);
  drawRiderDot();
  if (route.valid && route.pointCount > 0 && location.segmentIndex != HUD_SEGMENT_NONE) {
    drawRouteSteps(route, location.segmentIndex, 204, 12);
  }
  return true;
}

void Display::drawArrow(int16_t centerX, int16_t centerY, int16_t angle, float tipLength,
                        float baseLength, uint16_t color) {
  const float radians = angle * PI / 180.0f;
  const int16_t tipX = centerX + static_cast<int16_t>(sinf(radians) * tipLength);
  const int16_t tipY = centerY - static_cast<int16_t>(cosf(radians) * tipLength);
  const int16_t leftX = centerX + static_cast<int16_t>(sinf(radians + 2.45f) * baseLength);
  const int16_t leftY = centerY - static_cast<int16_t>(cosf(radians + 2.45f) * baseLength);
  const int16_t rightX = centerX + static_cast<int16_t>(sinf(radians - 2.45f) * baseLength);
  const int16_t rightY = centerY - static_cast<int16_t>(cosf(radians - 2.45f) * baseLength);

  tft_.drawLine(centerX, centerY, tipX, tipY, color);
  tft_.drawLine(tipX, tipY, leftX, leftY, color);
  tft_.drawLine(tipX, tipY, rightX, rightY, color);
}

void Display::drawLabel(const char* text, int16_t x, int16_t baseline, uint16_t color) {
  tft_.setFont(&FreeSans9pt7b);
  tft_.setTextColor(color);
  tft_.setCursor(x, baseline);
  tft_.print(text);
}

void Display::drawValueRight(const char* text, int16_t right, int16_t baseline, uint16_t color) {
  tft_.setFont(&FreeSansBold12pt7b);
  int16_t boundX = 0;
  int16_t boundY = 0;
  uint16_t boundW = 0;
  uint16_t boundH = 0;
  tft_.getTextBounds(text, 0, 0, &boundX, &boundY, &boundW, &boundH);
  tft_.setTextColor(color);
  tft_.setCursor(right - static_cast<int16_t>(boundW), baseline);
  tft_.print(text);
}

void Display::drawStatsLayout() {
  tft_.fillScreen(COLOR_BG);
  drawLabel("SPD", 14, 36, COLOR_CYAN);
  drawLabel("REM", 14, 150, COLOR_ORANGE);
  drawLabel("MAX", 14, 188, COLOR_VIOLET);
  drawLabel("TOT", 14, statTotBaseline_, COLOR_YELLOW);
  tft_.drawFastHLine(12, 114, TFT_WIDTH - 24, COLOR_DARK);
  layoutDrawn_ = true;
}

void Display::drawSpeedValue(uint16_t color) {
  char buf[8];
  snprintf(buf, sizeof(buf), "%u", static_cast<unsigned>(lastSpeed_));
  tft_.fillRect(4, 50, 138, 54, COLOR_BG);
  tft_.setFont(&FreeSansBold24pt7b);
  tft_.setTextColor(color);
  tft_.setCursor(14, 92);
  tft_.print(buf);
}

void Display::drawRowValue(uint16_t value, int16_t baseline, uint16_t color) {
  char buf[8];
  snprintf(buf, sizeof(buf), "%u", static_cast<unsigned>(value));
  tft_.fillRect(150, baseline - 22, 86, 30, COLOR_BG);
  drawValueRight(buf, 226, baseline, color);
}

void Display::drawTotalValue(uint16_t tenthsKm, int16_t baseline, uint16_t color) {
  char buf[10];
  hudFormatTenthsKm(tenthsKm, buf, sizeof(buf));
  tft_.fillRect(150, baseline - 22, 86, 30, COLOR_BG);
  drawValueRight(buf, 226, baseline, color);
}

void Display::drawNavArrow(bool fresh) {
  tft_.fillRect(140, 18, 94, 92, COLOR_BG);
  tft_.drawCircle(186, 64, 44, fresh ? COLOR_GREEN : COLOR_DARK);
  drawArrow(186, 64, fresh ? lastAngle_ : 0, 30.0f, 22.0f, fresh ? COLOR_GREEN : COLOR_GRAY);
}

void Display::drawLinkDot(bool fresh) {
  tft_.fillRect(10, 8, 16, 16, COLOR_BG);
  tft_.fillCircle(18, 16, 5, fresh ? COLOR_GREEN : COLOR_RED);
}

void Display::updateStats(const HudTelemetry& telemetry, const HudRoute& route, bool fresh) {
  const uint16_t valueColor = fresh ? COLOR_WHITE : COLOR_GRAY;
  const bool routeActive = route.valid && route.pointCount > 0;

  if (!layoutDrawn_ || routeActive != layoutWithRoute_) {
    layoutWithRoute_ = routeActive;
    statTotBaseline_ = routeActive ? 184 : 226;
    drawStatsLayout();
    lastSpeed_ = lastRemaining_ = lastAverage_ = lastTotal_ = -1;
    lastAngle_ = -1000;
    lastFresh_ = !fresh;
    lastSegmentIndex_ = -1;
  }

  if (telemetry.speed != lastSpeed_ || fresh != lastFresh_) {
    lastSpeed_ = telemetry.speed;
    drawSpeedValue(valueColor);
  }
  if (telemetry.remaining != lastRemaining_ || fresh != lastFresh_) {
    lastRemaining_ = telemetry.remaining;
    drawRowValue(telemetry.remaining, 150, valueColor);
  }
  if (telemetry.average != lastAverage_ || fresh != lastFresh_) {
    lastAverage_ = telemetry.average;
    drawRowValue(telemetry.average, 188, valueColor);
  }
  if (telemetry.totalTenthsKm != lastTotal_ || fresh != lastFresh_) {
    lastTotal_ = telemetry.totalTenthsKm;
    drawTotalValue(telemetry.totalTenthsKm, 226, valueColor);
  }
  if (telemetry.navAngle != lastAngle_ || fresh != lastFresh_) {
    lastAngle_ = telemetry.navAngle;
    drawNavArrow(fresh);
  }
  if (fresh != lastFresh_) {
    drawLinkDot(fresh);
    lastFresh_ = fresh;
  }

  const int16_t segment = routeActive ? static_cast<int16_t>(telemetry.segmentIndex) : HUD_SEGMENT_NONE;
  if (routeActive && segment != HUD_SEGMENT_NONE) {
    if (segment != lastSegmentIndex_) drawRouteSteps(route, static_cast<uint8_t>(segment), statTotBaseline_ + 20, 12);
  } else if (!routeActive && lastRouteActive_) {
    tft_.fillRect(0, 196, TFT_WIDTH, TFT_HEIGHT - 196, COLOR_BG);
  }
  lastRouteActive_ = routeActive;
  lastSegmentIndex_ = segment;
}
