Dasiuss/Szusownik/firmware/Szusownik/src/core/hud_format.h

#pragma once
#include <stddef.h>

// Czyste formatowanie pól HUD (bez Arduino) — testowane hostowo.
// Font Adafruit GFX jest ASCII, więc etykiety są transliterowane wyżej
// (np. "WYSOKOSC"); tu tylko liczby i czas.

namespace core {

// "HH:MM" z UTC + offsetMin (minuty mogą być ujemne). hour < 0 => "--:--".
void formatLocalHm(int utcHour, int utcMinute, int offsetMin, char* out, size_t n);

// Liczba całkowita z zakresu [0, maxValue], format "%d".
void formatUint(char* out, size_t n, float value, int maxValue);

// Dystans w km z jednym miejscem po przecinku, "%.1f", zakres [0, 999.9].
void formatTenthsKm(char* out, size_t n, float km);

// Wysokość w metrach z przyrostkiem "m", zakres [0, 99999].
void formatMeters(char* out, size_t n, float meters);

// Skrót nazwy odcinka trasy na jedną linię OLED: nazwy <= 6 znaków bez zmian,
// nazwy >= 7 znaków -> pierwsze 3 + '.' + ostatnie 2 (max 6, np. "Gaislachkogl"
// -> "Gai.gl").
void formatRouteLabel(const char* in, char* out, size_t n);

// Para maksimów na jedną linię: "zjazd / dzien", oba clamp 999
// (np. "60 / 80"). Używana w trybie trasy zamiast osobnych MAX ZJAZDU/MAX DNIA.
void formatMaxPair(char* out, size_t n, float maxRunKmh, float maxDayKmh);

}  // namespace core
