Dasiuss/Szusownik/(commit log)

2026-08-19 docs: BOM osobny plik + OLED, finalne sygnały dźwiękowe, roadmapa wykres
2026-08-20 docs: IMU+baro+EKF w roadmapie, usunięta sekcja Analiza
2026-09-11 Szusownik MVP1: firmware (GPS+UBX, CSV, buzzer, OLED, BLE streaming) + scaffold PWA + deploy na Pages
    [Szusownik.ino, audio.cpp, audio.h, config.h, gnss.cpp]
2026-09-11 buzzer: intuicyjne pikniecia 60-90, szybsze/krotsze/nisze freq, adaptacyjna glosnosc 60/120 z PWA (NVS, SETVOL), sygnal startowy; docs+AGENTS (procedura upload+monitor)
    [Szusownik.ino, audio.cpp, audio.h, config.h]
2026-09-11 AGENTS: procedura monitora przez monitor_COM7.cmd w osobnym oknie (arduino-cli monitor nie dziala bez TTY)
2026-09-16 PWA: redesign UX and persist runs
    [ride.csv]
2026-09-16 audio: fix BLE settings feedback and defaults
    [audio.cpp, audio.h, config.h]
2026-09-19 PWA: link all piste-piste junctions, paint markers before routing, add dev scripts and test data
    [LOG_1605.csv]
2026-09-20 PWA: move lift icon source to docs/assets, drop cut previews
2026-09-24 ESP: add barometer and thermal health monitor
    [ride.csv]
2026-09-25 test data: replace LOG_1605 with LOG_1641 and LOG_1653
    [LOG_1605.csv, LOG_1641.csv, LOG_1653.csv]
2026-09-25 ESP/PWA: per-run CSV rotation, v2-only parser, real demo fixture
    ESP: rotate one file per detected uphill using cumulative altitude thresholds; drop the 5-run/lift-speed heuristic and SZ_RUNS_PER_FILE.
    PWA: accept only CSV v2, remove v1 parsing and synthetic demo GNSS seeding; purge stale demo-* files on seed.
    demo: replace fixture with the real LOG_1641 recording (2 runs, real baro/GNSS); docs updated accordingly.
    [ride.csv]
2026-09-26 ESP: only probe SD on real read error, not normal EOF
2026-09-26 PWA: analyze merged trace across files
2026-09-26 BLE: incremental LIST:<since> + persistent retry queue by name
    Replace per-file FILE:<i> listing (O(all files), unstable FAT index) with
    name-cursor listing. Filenames are GNSS YYYYMMDD_HHMMSS, so they sort
    chronologically and act as a natural cursor in LIST:<since>.
    Firmware:
    - Storage::listCsv(since, max, out): up to SZ_BLE_LIST_MAX (12) oldest
    names > since, ascending, .meta-only filter retained.
    - CTRL LIST:<since> returns STATUS 'list <name> <size> ...'; empty = no new.
    - Drop FILE:<i> and LIST_FILES (greenfield, no back-compat).
    PWA:
    - Cursor meta.syncCursor = highest resolved name; pendingFiles table for
    transient failures, retried by name without listing.
    - New files discovered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
    [config.h]
2026-09-27 ESP: fix CTRL heap corruption - consume commands via onWrite queue
    NimBLE 2.5.1 writeEvent() calls setValue() on the host task (realloc of
    m_value), while poll() called chrCtrl->getValue() which deepCopy()s reading
    source.m_capacity outside the critical section and memcpy'ing
    m_attr_len + 1 bytes. The race overflowed the copy buffer and corrupted
    the heap (CORRUPT HEAP ... got 0x00767363 = trailing '...csv' of a
    START_FILE command), crashing during sync.
    - Capture CTRL writes in NimBLECharacteristicCallbacks::onWrite (host
    task, no concurrent mutation) into a ring buffer drained by the main
    loop. Stop calling getValue() from the loop.
    - Pre-grow INFO/STATUS value capacity once in begin(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
2026-09-27 ESP/PWA: report SD read errors instead of faking empty success
    Device log showed read()=0 at pos=0 for valid, PC-readable files (e.g.
    21005 B), while 501/844 B files read fine - the ESP could not traverse
    multi-cluster files. The firmware silently turned that into 'done raw=0'
    (empty stream), so the PWA blamed a bad CSV header.
    - Storage tracks readError when read()=0 while pos<size (not EOF);
    pumpStream aborts with err:read instead of finishing.
    - Transfer statuses carry the file name: 'streaming <name>',
    'done <name> raw=..', 'err:<code> <name>' - so the PWA can tell the
    current transfer's response from the previous one.
    - PWA pollTransfer(name,...) waits for a status naming THIS fi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
    [20260926_181014.csv, 20260926_181420.csv, 20260926_182356.csv, LOG_1641.csv, LOG_1653.csv]
2026-09-27 PWA: watch STATUS during transfer so mid-transfer abort fails fast
    Firmware sets 'streaming <name>' first and only later (e.g. err:read on a
    bad SD read) sets 'err:<code> <name>' without an end marker. The PWA saw
    'streaming', entered the frame loop and waited for the end marker until the
    120 s transfer timeout, looking like a hang. Poll STATUS every ~250 ms in
    the frame loop and abort on an err matching the current file.
2026-09-27 ESP: read SD files one sector at a time to avoid CMD18 multi-block failures
    Diagnosis from the card's FAT and a size sweep: files <=1 KB read fine,
    >=4 KB return read()=0 at offset 0. The FS layer opens files with a 4096 B
    stdio buffer (DEFAULT_FILE_BUFFER_SIZE), so fread(512) refills 4096 B and
    FatFs coalesces full sectors into a single multi-sector disk_read (CMD18).
    On this card/wiring that multi-block read fails, so larger files fail while
    files with <1024 B (count==1, single-sector CMD17) succeed. Clusters and
    write origin do not matter (a copy of a failing file in a different cluster
    behaves the same).
    Force a 512 B buffer in openRead so every disk_read is one sector.
2026-09-27 ESP: fix pend_ staging overflow that crashed multi-frame transfers
    With the SD read fixed, a 21 KB file (many frames) panicked with
    StoreProhibited writing at 0xf851f33c in pumpStream (ble.cpp:537). The loop
    appended the whole compressor output to pend_ BEFORE draining full frames.
    When pacing (4 ms) blocked emitFrame, pumpStream returned with pend_ still
    full, and the next poll appended more, overrunning pend_[512] (sized only
    for one 256 B output + a partial 240 B frame).
    Reorder the loop: emit a full frame first, and only compress/append when
    pendLen_ < 240, so pend_ is bounded by 239 + 256 < 512. No transfer-profile
    change (244/240/128/ACK32/pacing untouched); tiny files never hit it.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
2026-09-27 docs: record SD single-sector read and pumpStream staging-order invariants
    Both were latent firmware bugs only reachable once multi-KB transfers
    worked. Add the why to ble-transfer.md and a working rule to AGENTS.md
    (rule 3) so they are not reintroduced.
2026-10-03 test: pelne pokrycie PWA (Vitest/Playwright) + testy hostowe firmware
    - wspolny protokol: protocol/ble-file-v1.json jako SSOT + generator (web/src/lib/protocol.ts, firmware/Szusownik/src/config/protocol.h) i test zgodnosci
    - firmware: czysta logika w src/core/ + natywne testy Catch2 (firmware/test/host/run.ps1); CRC32 realnego nagrania == golden z urzadzenia (raw=216651 crc=CF1B7DB8)
    - PWA: unit + integracja (fake-indexeddb + symulator urzadzenia) oraz e2e Playwright (boot, sync, widoki, mapa z mockiem Overpass)
    - docs/testy.md + regula 16 w AGENTS.md; usunieto nieaktualne pliki test data
    [20260926_181014.csv, 20260926_182356.csv]
2026-10-03 BLE: throttle NACK to one per gap and coalesce replay
    A single lost frame made the PWA send a NACK for every out-of-order frame.
    Each NACK is a write-with-response CTRL round trip (~tens of ms), so the storm
    blocked reception, worsened loss and filled the sender window, ending in a GATT
    NotSupportedError around frame 28 (the decompressor 'write fail' was only the
    finally/abort side effect).
    PWA: send NACK only once per distinct missing sequence (nackSentFor).
    ESP: ignore a NACK while a replay from <= e is already in flight.
    Integration test pins the NACK count (3 gaps => exactly 3 requests; was 74).
    Frozen frame profile untouched.
2026-10-03 docs: make test-first (TDD) an explicit working rule
    Bugs are reproduced in a test before the fix, new features start with a test. Prefer integration/e2e; unit only for heavy isolated logic. Uncoverable layers are decided case by case with a short justification. Fix the reversed strategy wording in docs/testy.md and rule 16.
2026-10-03 PWA: zoom i pan wykresow po osi dystansu
    - Ctrl+kolo/pinch (trackpad) i przeciaganie; podwojny tap/klik resetuje
    - wspolny zakres X dla wykresu predkosci i wysokosci, clamp do zakresu danych
    - dotyk: pinch + poziomy pan jednym palcem, pion przewija strone (touch-action: pan-y)
    - drobniejsze ticki (0.1 i 0.05 km) dobierane do szerokosci okna, bez rozciagania domeny
    - testy: unit logiki w chart.test.ts + e2e gestow (Ctrl+kolo, drag, reset)
    - docs/wymagania-PWA.md 5: opis zoomu/panu
2026-10-03 PWA: ciecie zjazdow ZigZag z histereza (model B)
    Zjazd = odcinek szczyt->dolek wygladzonej wysokosci, a podejscie (wyciag) >= 5 m jest luka miedzy zjazdami. Prog dziala jak histereza, wiec szum probek i czestotliwosc probkowania nie rozbijaja zjazdu (bylo 2 zjazdy z realnego przejazdu, jest 5). Przerwa >= 1 h zamyka zwrot. Generator syntetyczny z K wyciagami daje K+1 zjazdow; testy niezmienniczosci na probkowanie.
2026-10-03 PWA: wspolna os dystansu na wykresie dnia po cumDistM (naprawa cofania)
    Wykres 'Caly dzien' skladal os przez sumowanie run.distanceM, a pozycja probek szla po pelnej rozpietyzosci z wyciagiem - od odkad distanceM nie zawiera wyciagu, linia cofala sie na granicach zjazdow. Helpery wydzielone do lib/dayChart.ts z testem regresyjnym (os monotoniczna).
2026-10-03 PWA: szerokosc kart Podzialu trasy po rozpietyzosci segmentu (spojna z wykresem)
    Karty uzywaly distanceM (bez wyciagu) do flexGrow, a linie granic na wykresie ida po rozpietyzosci probek - ujednolicone przez runSampleSpanM.
2026-10-04 PWA: popraw wysokosc GPS w fixture demo i wymus reseed
    [ride.csv]
2026-10-04 PWA: dopasowanie zjazdow do tras OSM + generowane demo Solden
    Dopasowanie zjazdow (routeMatching): grupowanie tras po site+label, dopasowanie od najwyzszego punktu w dol, promien 50 m, zaliczenie >=100 m wzdloz geometrii, scalanie luk <60 m; nazwa zjazdu = sekwencja tras + sekcja Poprzednie przejazdy; backfill po pobraniu cache OSM (marker matching-osm-*).
    Demo PWA: web/public/fixtures/ride.csv jest generowany przez scripts/gen-demo-ride.mjs na prawdziwej geometrii Solden (scripts/data/demo-solden.json): petla Gaislachkoglbahn II + zjazd 1 -> 1a, 3 zjazdy, CSV v2.
    Testy: routeMatching.test.ts, demoFixture.test.ts, e2e run-routes.spec.ts. Dokumentacja: mapy-routing par.9, wymagania-PWA par.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
    [ride.csv]
2026-10-04 PWA: mini-mapa sladu 2D nad wykresami + aktualizacja dokumentacji
    Mini-mapa (TraceMap, lazy) w szczegolach zjazdu i w widoku Caly dzien: MapLibre 2D z podkladem OpenTopoMap, stala orientacja (bearing -90, bez obrotu), bez terenu 3D; trasy delikatne (obwodka 4/opacity 0.55, linia 2/opacity 0.55), wyciagi, slad gruby kolorowany predkoscia (scalany w jedna linie per przedzial predkosci - bez fasolek). Przycisk powiekszenia kafelka 240 px <-> 75vh. Nowa czysta logika traceMap.ts + testy; loadSkiData deduplikuje rownolegle zapytanie Overpass.
    Dokumentacja: mapy-routing par.5 (mini-mapa), wymagania-PWA par.4/5/9, testy.md, ustalenia, AGENTS regula 20; poprawki nieaktualnych opisow (schemat v6, de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
2026-10-09 HudRekaw: statyczny bufor labeli mapy (naprawa resetu po ramce L)
    Bufor kandydatow labeli byl lokalna tablica na stosie (~220 x 20 B = ~4,4 KB) przy 4 KB stosu loop() ESP8266, wiec pierwsza ramka L przepleniala stos i resetowala odbiornik (objaw: mapa mignie, wraca ekran statystyk, podglad pokazuje last packet: never). Przeniesiony do pamieci statycznej, jak w odbiorniku DisplayTest. Brak testu hostowego: to ograniczenie stosu sprzetu, nie logika core.
    [display.cpp]
2026-10-09 Docs: procedura wgrywania firmware (Szusownik COM7, HudRekaw OTA)
    AGENTS.md: rozdzielone dwie drogi — Szusownik po kablu na COM7, HudRekaw tylko przez OTA. Dokladne komendy: ustalenie IP, espota (arduino-cli upload), niezawodne wgranie przez HTTP /update (compile + curl) oraz SoftAP 192.168.4.1 bez secrets.h. .gitignore: *.map (artefakt --output-dir).
2026-10-09 HudRekaw: martwa strefa przerysowania mapy + jedna transakcja SPI
    Rysowanie mapy pomijane, dopoki rower nie przesunie sie o MAP_REDRAW_MOVE_M (5 m) albo kurs nie zmieni sie o MAP_REDRAW_BEARING_DEG (8 st., z zawijaniem 0/360); zmiana trybu/zoomu/fisheye wymusza rysunek. Przy postoju ekran nie miga.
    Polilinie rysowane w jednej transakcji SPI (startWrite/endWrite + writePixel przez drawMapLine, bo Adafruit_GFX::drawLine otwiera wlasna transakcje na segment). Logika progu czysta w map_math (mapShouldRedraw) z testami hostowymi.
2026-10-09 PWA: wykresy profilu (tryby, przyspieszenie, punkt na mapie) + demo
    - Wspolna sekcja wykresow dla zjazdu i dnia: predkosc, wysokosc, przyspieszenie; klikalna legenda.
    - Dwa tryby przelaczane w naglowku, zapamietywane globalnie w localStorage: polaczony (os przyspieszenia ukryta) i osobny (trzy wykresy, wspolna os X, zsynchronizowany kursor i tooltipy).
    - Przyspieszenie = delta speedSm/delta t w km/h/s, liczone per zjazd, z wygladzeniem i przerwaniem na luce; os symetryczna wokol zera z podloga.
    - Najechanie/tap na wykresie pokazuje probke na mini-mapie (HTML Marker).
    - Generator demo: ciagly profil predkosci (usuniete skoki faz zjazdu), regenerowany fixture, reseed demo-seeded-v6.
    - Tes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
    [ride.csv]
2026-10-09 Firmware: HUD Szusownika jako jeden ekran statystyk (hero max zjazdu)
    Nowy uklad OLED 128x64: lewa kolumna MAX ZJAZDU (hero) + DYSTANS, prawa czas lokalny, SPEED/SPD, MAX DNIA, WYSOKOSC (fuzja baro+GPS). NO FIX zastępuje slot SPEED; dolna linia zarezerwowana na przyszłą trasę z PWA.
    Hero liczy core::RunTracker — strumieniowy port ZigZag z PWA (fuzja baro+GPS tau=10s -> MA5 -> histereza 5 m): live w zjezdzie, zamrozony na wyciagu. Formatowanie w core::hud_format. Testy hostowe (test_run_tracker, test_hud_format). Mapa/bitmapy/animacja usuniete z planu; docs przepisane.
    [Szusownik.ino, config.h, gnss.cpp, gnss.h, hud_format.cpp, hud_format.h]
2026-10-10 Tooling/docs: przyrostowy build testów hostowych + porządki w AGENTS.md
    run.ps1: build przyrostowy (kazdy .cpp -> .o tylko gdy nowszy niz zrodlo/naglowki, wspoldzielony prekompilowany Catch2), flagi -Filter i -Binaries oraz --allow-running-no-tests. Powtorka bez zmian ~2 s zamiast pelnej przebudowy. .gitignore: .build/.
    AGENTS.md: regula 4 spojna z portem ZigZag (SSOT ciecia zjazdow w PWA, urzadzenie robi lekka derywacje HUD), regula 5 bez nieaktualnych bitmap, regula 13 ze wskaznikiem gdzie zyje segmentacja zjazdu, usunieta sekcja 'Aktualne ograniczenia odziedziczone z testow'.
    docs/testy.md: opis przyrostowego builda i konwencja Catch2 (using Catch::Approx).
2026-10-10 Firmware: linia trasy na OLED Szusownika (kolejne odcinki od biezacego)
    Dolna linia ekranu w trybie nawigacji pokazuje liste odcinkow od biezacego segmentIndex, lacza ASCII '->', nazwy skracane (<=6 bez zmian, >=7 -> 3+'.'+2). Przy braku fixa odcinek zamrozony. Czysta logika: core::formatRouteLabel + core::routeFormatLine (testy hostowe); usunieto martwy truncateName.
    [Szusownik.ino, config.h, hud_format.cpp, hud_format.h, route.cpp, route.h]
2026-10-11 Firmware: OLED z trasa - wieksza linia trasy i MAX (zjazd/dzien)
    Tryb trasy: linia trasy zwiekszona do rozmiaru 2 (SZ_HUD_ROUTE_CHARS 21->10, 12 px/znak, x=1, y=48) i bez separatora nad nia. Para maksimow zwija sie do jednej pozycji 'MAX zjazd / dzien' (etykieta MAX, wartosc size 2), a DYSTANS i prawa kolumna (czas, SPD/NO FIX, WYSOKOSC) maleja do size 1. Nowy czysty helper core::formatMaxPair. Bez trasy uklad bez zmian.
    Testy hostowe: 186 asercji / 43 przypadki (Szusownik), 94 / 17 (HudRekaw). Kompilacja esp32s3 OK. Render na OLED - manualnie, niepotwierdzony sprzetowo.
2026-10-11 PWA: ciche zerwanie lacza BLE wraca do offline (zamiast bledu GATT)
    Brak obslugi gattserverdisconnected: po cichym zerwaniu (urzadzenie wylaczone/poza zasiegiem) bleRef zostawal ustawiony, wiec PWA probowala wyslac trase po martwym GATT i pokazywala surowy DOMException z Web Bluetooth zamiast podpowiedzi offline z przyciskiem.
    SzusownikBle nasluchuje gattserverdisconnected, eksponuje connected i onDisconnected oraz rzuca DeviceDisconnectedError z bramki requireLink() (server.connected + obecna charakterystyka trasy). DeviceProvider wraca do stanu rozlaczonego, a flushRoute mapuje rozlaczenie na routeSync=offline; jawny disconnect() z PWA nie udaje awarii lacza.
    Testy: routeSync.integration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
2026-10-11 PWA: postep laczenia i wysylki trasy w panelu trasy na mapie
    Panel trasy znal tylko routeSync, wiec w trakcie calego laczenia (picker -> GATT -> LIST) pokazywal 'Polacz, aby wyslac trase' z aktywnym przyciskiem: klikniecie nic nie zmienialo i mozna bylo klikac w kolko.
    Wiersz stanu liczy teraz routeSyncNotice() z deviceState i routeSync: 'Lacze z urzadzeniem...' (przycisk schowany), 'Polaczono, sprawdzam urzadzenie...', 'Wysylam trase na urzadzenie...', a przy nieudanym laczeniu powod + 'Polacz' do ponowienia. Sukces nadal milczy (wiersz znika), wiec automatyczne dosylki w nawigacji nie migaja.
    Testy: routeSyncNotice.test (9 przypadkow, priorytet laczenia nad stanem wysylki). E2E panelu tr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
2026-10-11 HACK: PWA w trybie Wroclaw (dolna polowa Wojszyc) do testu wysylki trasy
    Tymczasowy hack do testu trasy PWA -> Szusownik -> HudRekaw we Wroclawiu.
    - Przelacznik MAP_MODE w mapData.ts ("road"; revert: "ski" + usunac fixture).
    - Fixture web/public/overpass-wroclaw.json (kopia scripts/data/overpass-wroclaw.json).
    - Normalizacja highway -> linie routowalne (bez czarnych trudnosci).
    - findRoute w trybie road dodaje krawedzie dwukierunkowe.
    - MapView/TraceMap/App uzywaja ACTIVE_BOUNDS/CENTER i HOME_COORDINATES.
    - Domyslne tryby funkcji pozostaja "ski", wiec istniejace testy bez zmian
    (169 zielonych; build przechodzi).
2026-10-11 Firmware: listCsv/countCsv przez opendir/readdir (bez otwierania plikow)
    openNextFile()/SD.open() na wpisie otwiera kazdy plik (na tej karcie ~O(n^2)), co dawalo skan LIST ~1,6 s i loop stall ~1,7 s. Teraz tanie opendir/readdir + stat() tylko dla wybranych (<= SZ_BLE_LIST_MAX).
2026-10-16 BLE: normalizacja bledu dekompresora + licznik notifyFail + monitoring do pliku
    PWA: writer.write() z 'undefined' nie jest juz polykany (bylo if(failed) na undefined) - uszkodzona ramka konczy sie bledem przejsciowym zamiast wisi do timeoutu. Log done z liczba dziur.
    Firmware: licznik notify() zwracajacych false (notifyFail w BLE done/abort, nf= w SYS) - rozdziela gubienie po stronie esp32 od klienta.
    Monitoring: monitor_COM7.cmd loguje jednoczesnie na konsole i do monitor_COM7.log (UTF-8, czyszczony na starcie); AGENTS.md opisuje uzycie.
    Docs: poprawiony blad - BleTest/BLE testowane glownie na Windowsie (takze Android), nie tylko Android; status pomiaru BLE.
2026-10-16 BLE: pojedynczy nieudany zapis ACK/NACK nie przerywa transferu
    safeWriteCtrl: hiccup GATT na zapisie kontrolnym jest tolerowany (urzadzenie replayuje po wlasnym timeoucie ACK); 3 nieudane pod rzad albo DeviceDisconnectedError przerywaja plik. Bez tego jeden NotSupportedError wywalal caly odebrany plik. Emulator: opcja failControlWrites + 2 testy. Docs par. 10.
2026-10-29 Typy: tsc -b w buildzie + przycinanie bez duplikatów wierzchołków
    - npm run build sprawdza typy przez `tsc -b` (wcześniej `tsc` czytał solution
    z pustym `files`, więc nic nie weryfikował)
    - naprawione błędy typów w nowym kodzie mapy (pmtilesSource, tileClip,
    basemapStyle, TraceMap, MapView) i w istniejącym (typy Web Bluetooth,
    testy generatorów protokołów, device-emulator)
    - clipLineToRect nie dubluje wierzchołka na styku odcinków (zerowe segmenty)
    - wysokość terenu dzielona przez `exaggeration` — MapLibre 6 zwraca ją
    przemnożoną, więc spadki były zaniżone o współczynnik terenu
    - błąd GPS jest wreszcie pokazywany (stan był ustawiany, ale nie renderowany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
2026-10-29 Mini-mapy: poziomice zależne od zoomu (profil zoom)
    - contourLevels.ts: czyste progi poziomic — duża mapa (`pitch`) bez zmian
    (stałe 50 m od z10), mini-mapy (`zoom`) podwajają interwał przy oddalaniu
    (400 m do z11, 200 m z12, 100 m z13, 50 m od z14), żeby poziomice nie
    dominowały obrazu przy dopasowaniu całego dnia
    - buildMapStyle przyjmuje `contourProfile` (domyślnie `pitch`)
    - TraceMap prosi o profil `zoom` (wspólny dla widoku zjazdu i dnia)
    - docs/mapy-routing.md: opis obu profili, aktualizacja sekcji mini-mapy
    - test: contourLevels.test.ts (progi + profil użyty przez mini-mapę)
